KGAtomTrapLab/ramp_gen_pcb/README.md

# ramp_gen_pcb
-PCB Files used for creating our custom voltage ramp electronics.

-Originally devloped ini Altium, migrated to KiCad 

-Additionaliy contains various documentation for componenents
