KGAtomTrapLab/ramp_gen_pcb/ramp_generatorV2.xlsx

Comment | Description | Designator | Footprint | LibRef | Quantity | Notes | Purchase Link
C3216JB1A106M160AA | Multilayer Ceramic Capacitors 10uF ±20% 10V JB SMD 1206 | C1, C2, C7, C8 | FP-C3216-160-0_2-IPC_C | CMP-08246-004766-1 | 12 |  | https://www.digikey.com/en/products/detail/tdk-corporation/C3216JB1A106M160AA/3948917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
CAP 100pF 100V 1206(3216) | CAP 100pF 100V ±1% 1206 (3216 Metric) Thickness 1mm SMD | C3, C4, C5, C6 | CAPC1206(3216)100_N | CMP-1037-01579-1 | 12 |  | https://www.digikey.com/en/products/detail/johanson-dielectrics-inc/202R18N101JV4E/1556356
5015 | PC TEST POINT MINIATURE | J1, J2 | FP-5015-MFG | CMP-2000-05183-2 | 10 |  | https://www.digikey.com/en/products/detail/keystone-electronics/5015/278885
61301221121 | CONN HEADER VERT 12POS 2.54MM | J3 | FP-61301221121-MFG | CMP-1502-01088-2 | 5 |  | https://www.digikey.com/en/products/detail/w%C3%BCrth-elektronik/61301221121/4846846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
1-1337445-0 | CONN BNC JACK STR 50 OHM PCB | J4, J6, J7 | FP-1-1337445-0-MFG | CMP-03357-000006-1 | 12 |  | https://www.digikey.com/en/products/detail/te-connectivity-amp-connectors/1-1337445-0/1889630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
24.243.1 | Banana Test Connector, 4mm, Socket, PCB Mount, 24 A, 60 VDC, Silver Plated Contacts, Green | J5, J9 | FP-24_243_1-MFG | CMP-12400-000001-2 | 10 |  | https://www.newark.com/multicomp/24-243-1/pcb-socket-4mm-red/dp/80P3616?CMP=AFC-OP
KTR18EZPJ102 | Res Thick Film 1206 1kΩ 5% 0.1W ±200ppm/°C Automotive Paper T/R | R1, R2 | FP-KTR18-IPC_A | CMP-08839-031408-1 | 10 |  | https://www.digikey.com/en/products/detail/rohm-semiconductor/KTR18EZPJ102/1763425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
 | Res Thick Film 1206 11kΩ 5% 0.1W ±200ppm/°C Automotive Paper T/R | R1, R2 | FP-KTR18-IPC_A |  | 10 |  | https://www.digikey.com/en/products/detail/rohm-semiconductor/KTR18EZPF1102/4052249
OPA452TA-1 | Operational Amplifier, 20 to 80 V, -40 to 125 degC, 7-pin FM (KVT7), Green (RoHS & no Sb/Br) | U1 | KVT0007A | CMP-0272-03697-4 | 4 |  | https://www.digikey.com/en/products/detail/rochester-electronics-llc/OPA452TA-1/11541280
MCP4921-E/P | 12-Bit DAC with SPI Interface, 8-Pin PDIP, Extended Temperature | U2 | PDIP300-P8 | CMP-0188-00217-2 | 4 | lead time Apr 10th | https://www.digikey.com/en/products/detail/microchip-technology/MCP4921-E-P/716280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
 | DESOLDER BRAID ROSIN 0.08" 5' |  |  |  |  |  | https://www.digikey.com/en/products/detail/chemtronics/80-3-5/306982
Arduino DUE | Documented Arduino |  |  |  | 2 |  | https://store-usa.arduino.cc/products/arduino-due?selectedStore=us
MCP4131-503E/P | SPI Digital Pot. 50k |  |  |  | 4 |  | https://www.digikey.com/en/products/detail/microchip-technology/MCP4131-503E-P/1874330
MCP4131-103E/P | SPI Digital Pot. 10k |  |  |  | 4 |  | https://www.digikey.com/en/products/detail/microchip-technology/MCP4131-103E-P/1874338
MCP3202-BI/P | 12 bit ADC |  |  |  | 3 |  | https://www.digikey.com/en/products/detail/microchip-technology/MCP3202-BI-P/319431
MCP3208-BI/P | ADC w/ more inputs (Pricey, might not need) |  |  |  | 2 |  | https://www.digikey.com/en/products/detail/microchip-technology/MCP3208-BI-P/319443
WLSK3012A | Soldering Iron |  |  |  | 1 |  | https://www.amazon.com/Weller-Variable-Wattage-Precision-Soldering/dp/B09632PQK1
 | Copper PCB Plate |  |  |  | 2 |  | https://www.amazon.com/GeeBat-Double-sided-Laminate-Thickness-Prototyping/dp/B01MRG7NHC
 | Jumper Wires |  |  |  | 2 |  | https://www.amazon.com/EDGELEC-Breadboard-Optional-Assorted-Multicolored/dp/B07GD2BWPY
 | Cleaner Jumper Wires |  |  |  | 1 |  | https://www.amazon.com/Sunxeke-Breadboard-Assortment-Solderless-Different/dp/B09NCYWK11
 | Wire Strippers |  |  |  | 1 |  | https://www.amazon.com/WGGE-Professional-crimping-Multi-Tool-Multi-Function/dp/B073YG65N2
 | Electric Tape |  |  |  | 1 |  | https://www.amazon.com/Scotch-Electrical-Tape-4-Inch-66-Foot/dp/B001ULCB1O
 | Soldering Flux |  |  |  | 1 |  | https://www.amazon.com/Soldering-Electronics-Tabbing-Welding-Maintenance/dp/B0953NGKXR
 | Solder Tip Cleaner |  |  |  | 1 |  | https://www.amazon.com/Soldering-Cleaner-Electronics-Metalworking-Cleaning/dp/B08VN9HWR2
