KGAtomTrapLab/ramp_gen_pcb/pcb/MCP4131-103E_P/MCP4131-103E_P.step

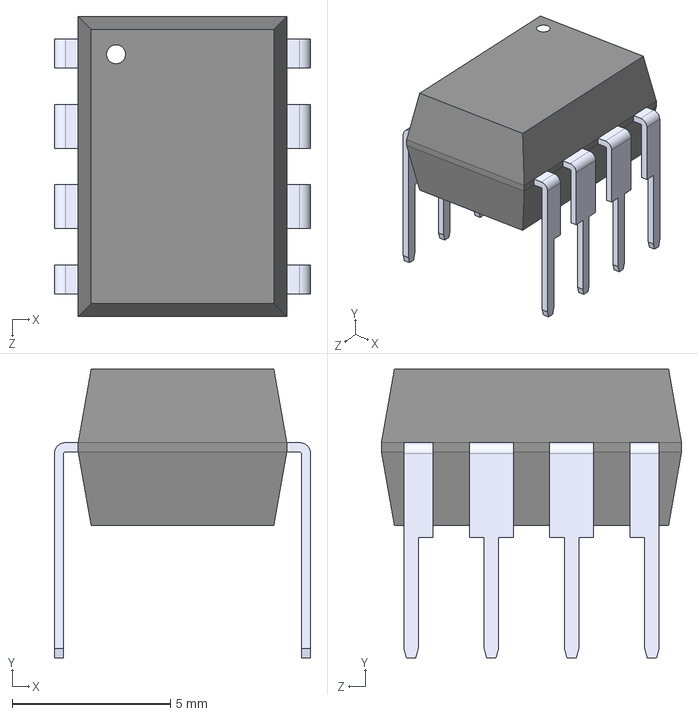
[picture p1: CAD file, 2023-11-29]
pcb/MCP4131-103E_P/MCP4131-103E_P.step
8.10 x 9.14 x 9.50 mm
