KGAtomTrapLab/ramp_gen_pcb/pcb/V2_rampGen.step

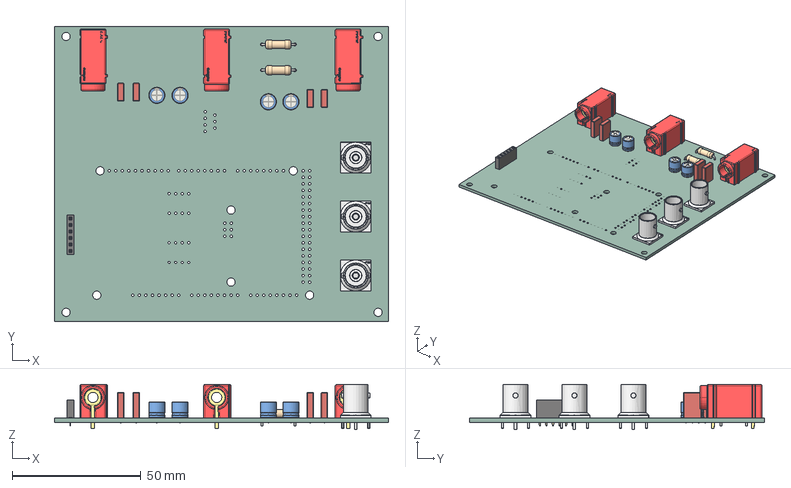
[picture p2: CAD file, 2024-09-30]
pcb/V2_rampGen.step
129.5 x 114.3 x 17.6 mm
C_Rect_L70mm_W25mm_P500mm x 4
R_Axial_DIN0411_L99mm_D36mm_P1270mm_Horizontal x 2
CP_Radial_D63mm_P250mm x 4
PinSocket_1x06_P254mm_Vertical
V2_rampGen_PCB
