KGAtomTrapLab/ramp_gen_pcb/pcb/ALTIUM_EMBEDDED_MODELS/Conn_Multicomp_24_243_1_eec.STEP

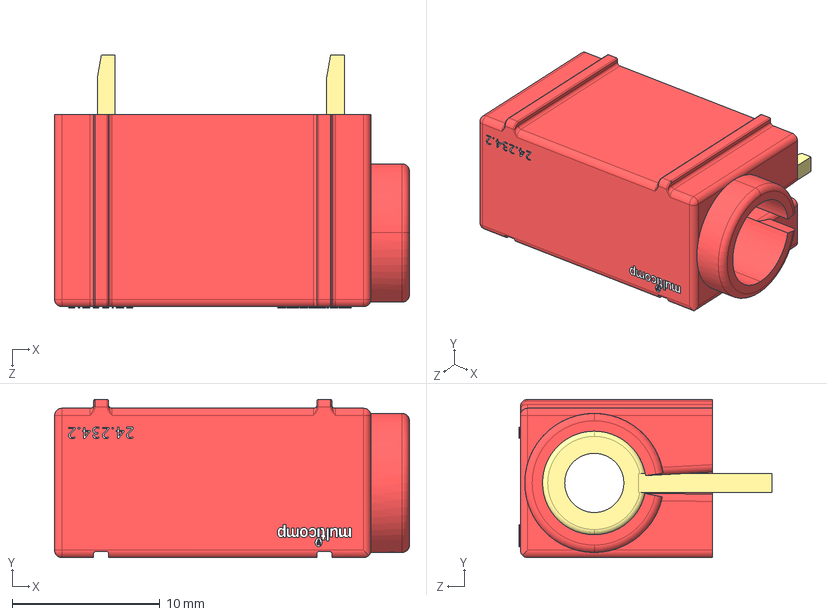
[picture p3: CAD file, 2023-11-29]
pcb/ALTIUM_EMBEDDED_MODELS/Conn_Multicomp_24_243_1_eec.STEP
24.0 x 10.7 x 17.1 mm
24.243.1_FRAME_Predeterminado
24.243.1_PIN_Predeterminado x 2
24.243.1_LOGO
