KGAtomTrapLab/ramp_gen_pcb/pcb/ALTIUM_EMBEDDED_MODELS/Conn_TE_Connectivity_1-1337445-0_eec.STEP

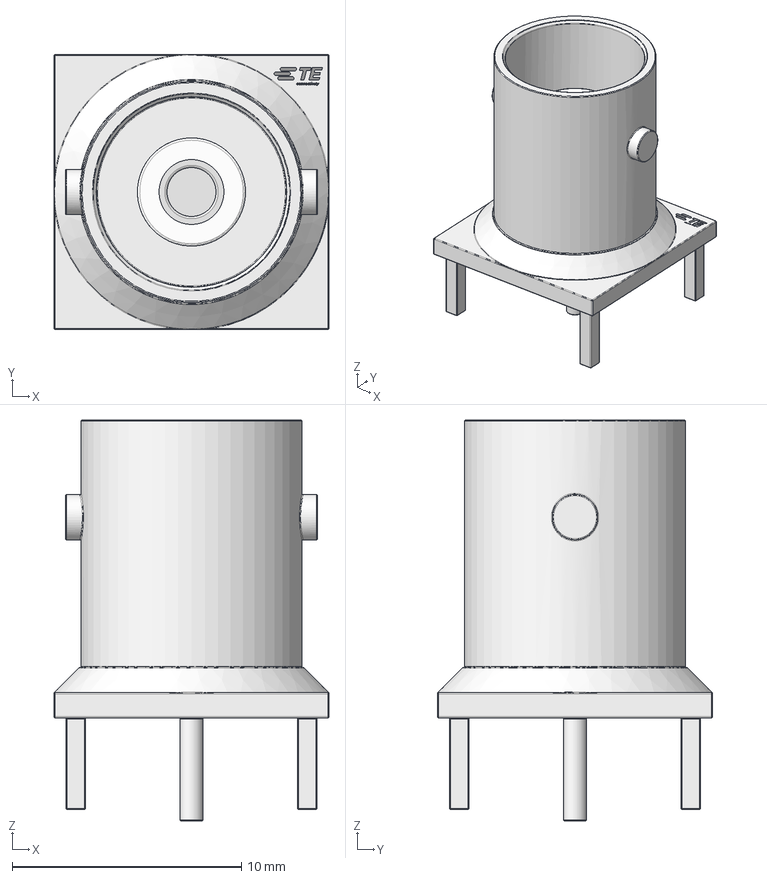
[picture p4: CAD file, 2023-11-29]
pcb/ALTIUM_EMBEDDED_MODELS/Conn_TE_Connectivity_1-1337445-0_eec.STEP
12.0 x 12.0 x 17.5 mm
TE Connectivity
