KGAtomTrapLab/ramp_gen_pcb/pcb/ALTIUM_EMBEDDED_MODELS/Res_Rohm_KTR18EZPF6043_eec.STEP

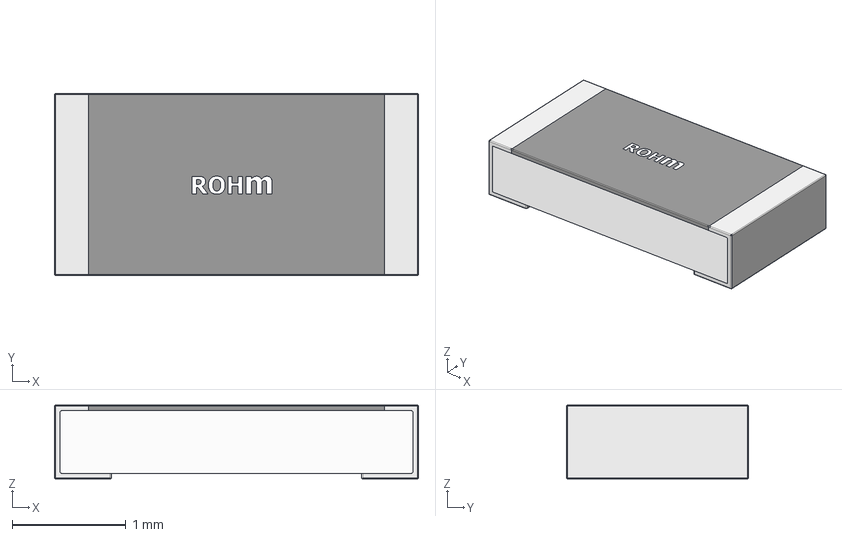
[picture p5: CAD file, 2023-11-29]
pcb/ALTIUM_EMBEDDED_MODELS/Res_Rohm_KTR18EZPF6043_eec.STEP
3.20 x 1.60 x 0.65 mm
Terminals
Logo
Coating
