KGAtomTrapLab/ramp_gen_pcb/pcb/ALTIUM_EMBEDDED_MODELS/Cap_TDK_C3216X7R1C106M160AC_eec.STEP

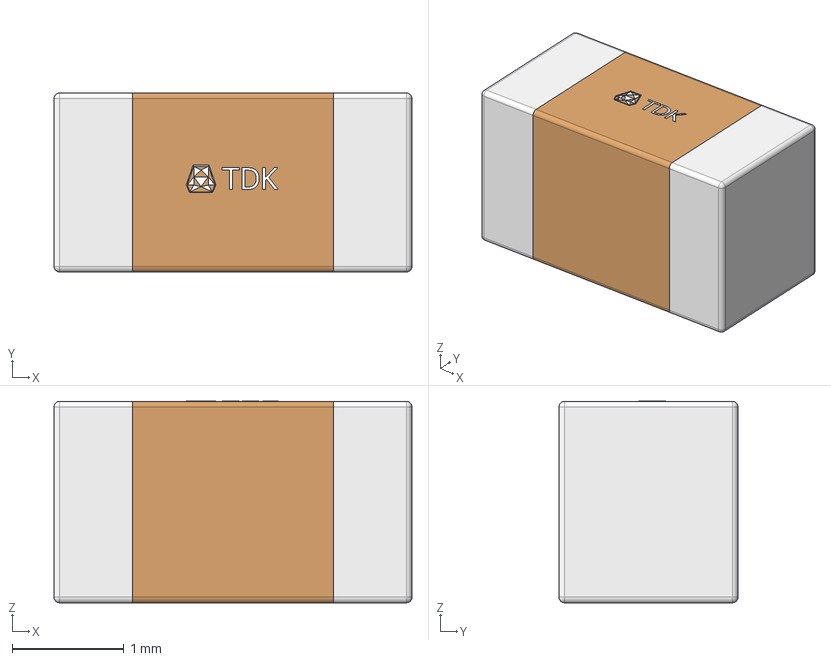
[picture p6: CAD file, 2023-11-29]
pcb/ALTIUM_EMBEDDED_MODELS/Cap_TDK_C3216X7R1C106M160AC_eec.STEP
3.20 x 1.60 x 1.80 mm
side x 2
name1
