KGAtomTrapLab/ramp_gen_pcb/pcb/ALTIUM_EMBEDDED_MODELS/61301221121.stp

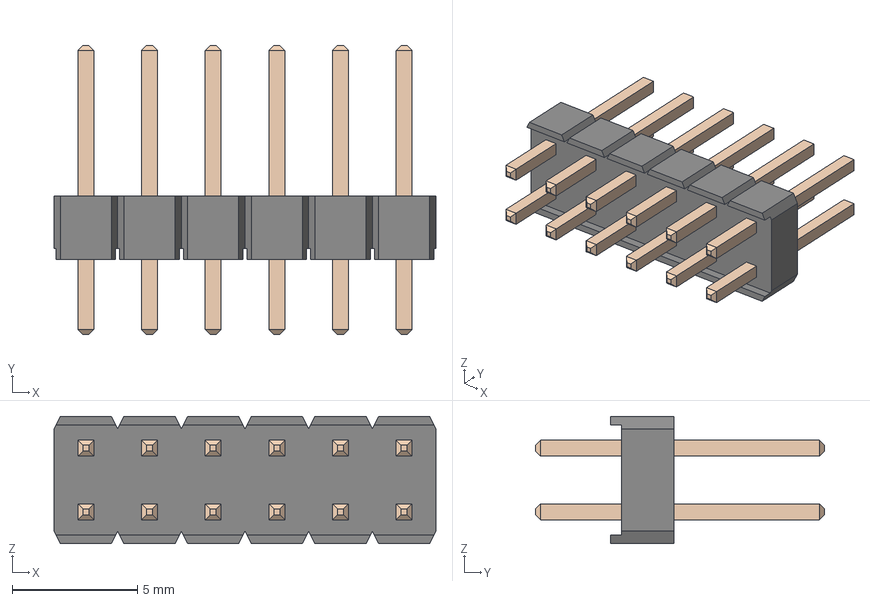
[picture p7: CAD file, 2023-11-29]
pcb/ALTIUM_EMBEDDED_MODELS/61301221121.stp
15.2 x 11.5 x 5.08 mm
6130xx21121_PIN x 12
