KGAtomTrapLab/ramp_gen_pcb/ramp_generator.pdf

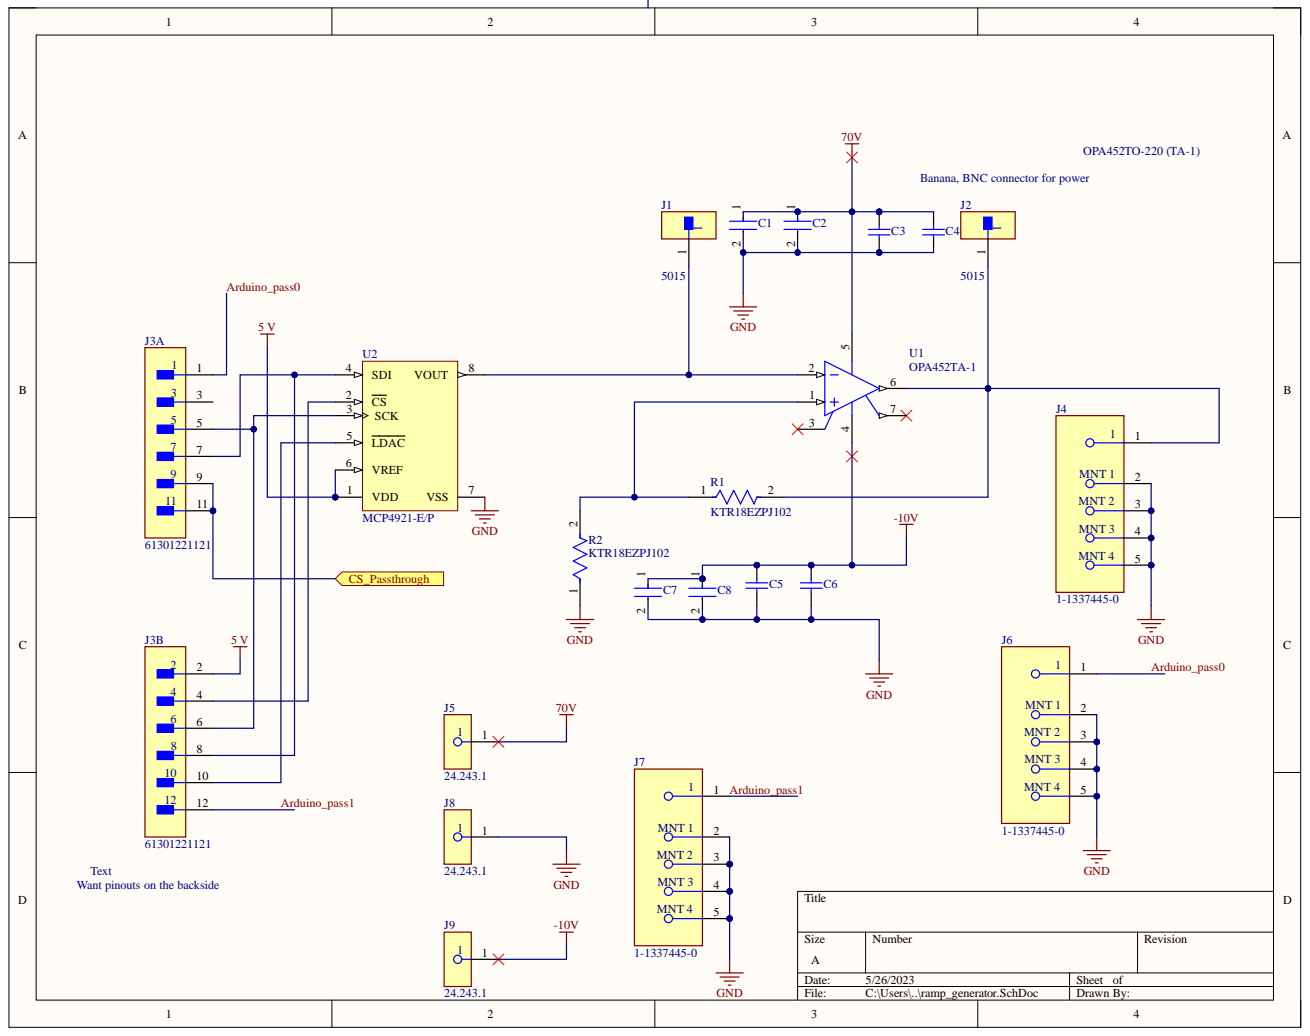
[picture p8: page 1]

Banana, BNC connector for power

Text
Want pinouts on the backside

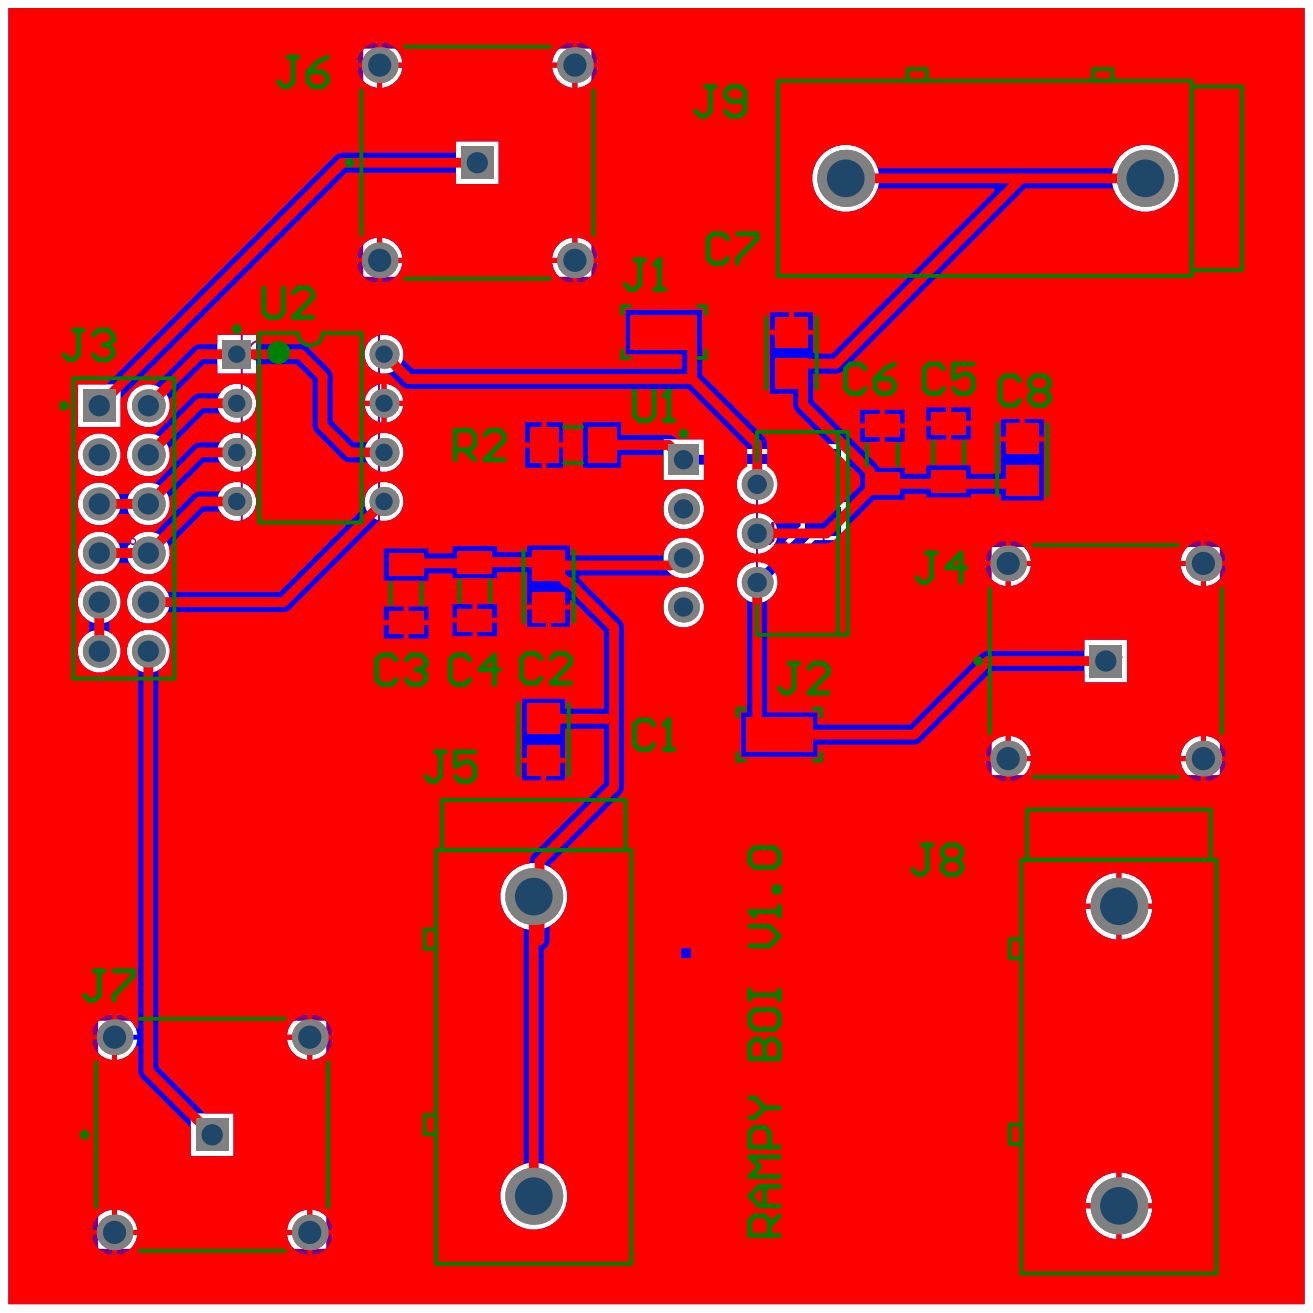
[picture p9: page 2]
