KGAtomTrapLab/ramp_gen_pcb/(list of files, drawings)

Other design files:
ALTIUM_OLD/V1/ramp_gen_v1.PcbDoc
ALTIUM_OLD/V1/ramp_generator.PrjPcb
ALTIUM_OLD/V1/ramp_generator.SchDoc
pcb/V2_rampGen.PcbDoc
pcb/V2_rampGen.SchDoc
