KGAtomTrapLab/ramp_gen_pcb/(commit log)

2023-06-07 Ramp gen V1 schematic and PCB files
    [ramp_gen_v1.PcbDoc, ramp_generator.PrjPcb, ramp_generator.SchDoc]
2023-06-07 Add files via upload
    Materials ordered for the first ramp PCB
    [ramp_generatorV2.xlsx]
2023-06-07 Create DataSheets
    the information for various components on the PCB
2023-06-07 added pdf of schematic and pcb
2023-11-29 converted to kicad files, organized folder
    [Cap_TDK_C3216X7R1C106M160AC_eec.STEP, Conn_Multicomp_24_243_1_eec.STEP, Conn_TE_Connectivity_1-1337445-0_eec.STEP, Conn_Wurth_Electronics_61301221121_eec.STEP, Res_Rohm_KTR18EZPF6043_eec.STEP, V2_rampGen.PcbDoc, V2_rampGen.SchDoc, ramp_gen_v1.PcbDoc]
2023-11-29 added sheild and pot
    [61301221121.stp, Conn_Wurth_Electronics_61301221121_eec.STEP, Legacy.kicad_pcb, MCP4131-103E_P.step, V2_rampGen.PcbDoc, V2_rampGen.SchDoc, V2_rampGen.kicad_pcb, V2_rampGen.kicad_sch]
2023-11-30 began routing, adding gnd plane
    [V2_rampGen.kicad_pcb, V2_rampGen.kicad_sch]
2024-01-29 more modifications and initial gerber files
    [V2_rampGen-B_Cu.gbr, V2_rampGen-B_Mask.gbr, V2_rampGen-B_Paste.gbr, V2_rampGen-B_Silkscreen.gbr, V2_rampGen-Edge_Cuts.gbr, V2_rampGen-F_Cu.gbr, V2_rampGen-F_Mask.gbr, V2_rampGen-F_Paste.gbr]
2024-01-30 finalized design for manufacturing
    [V2_rampGen-B_Cu.gbr, V2_rampGen-B_Mask.gbr, V2_rampGen-B_Paste.gbr, V2_rampGen-B_Silkscreen.gbr, V2_rampGen-Edge_Cuts.gbr, V2_rampGen-F_Cu.gbr, V2_rampGen-F_Mask.gbr, V2_rampGen-F_Paste.gbr]
2024-04-08 changed cap footprint
    [BOM-V2_rampGen.csv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]
2024-04-09 more footprint changed
    [V2_rampGen.kicad_pcb, V2_rampGen.kicad_sch]
2024-04-09 adjusted pcb layout
    [V2_rampGen.kicad_pcb, V2_rampGen.kicad_sch, untitled.kicad_sch]
2024-04-10 finalized capacitor and resistor footprints
    [V2_rampGen.kicad_pcb, V2_rampGen.kicad_sch]
2024-05-09 version 2.5 bump, corrected pot wiper pin
    [V2_rampGen.kicad_pcb, V2_rampGen.kicad_sch]
